shurik179/servo_controller/docs/photos/PXL_20240618_205056550.jpg

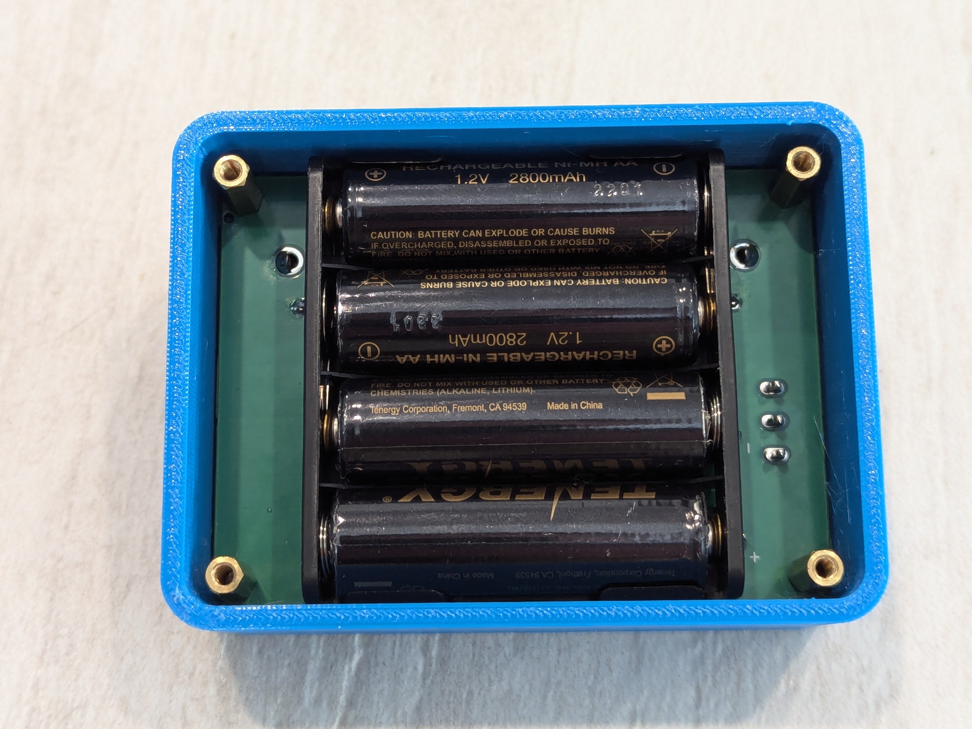
docs/photos/PXL_20240618_205056550.jpg
