shurik179/servo_controller/docs/photos/PXL_20240618_210146403.jpg

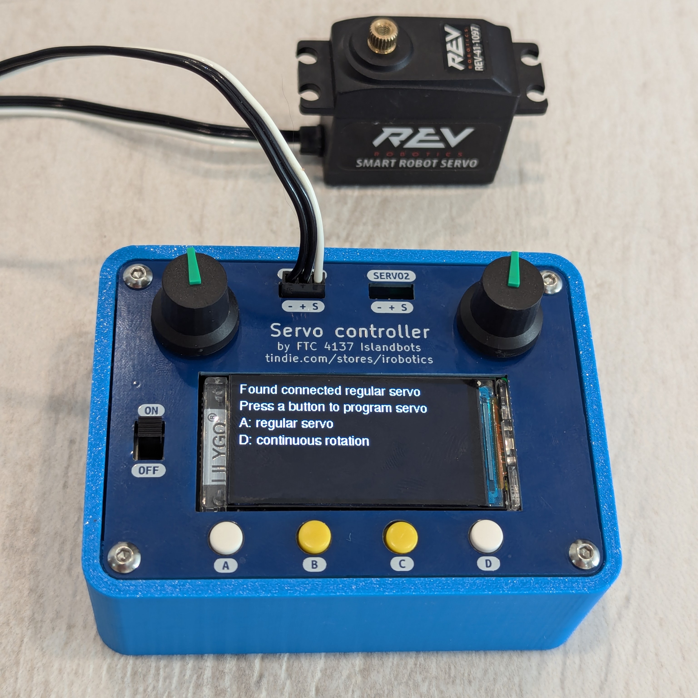
docs/photos/PXL_20240618_210146403.jpg
