shurik179/servo_controller/README.md

# Servo controller
This repository contains source files for the dual Servo Controller, desinged by members 
of FTC team 4137 Islandbots. 

For details, please see https://tindie.com/stores/irobotics/servo-controller
