shurik179/servo_controller/docs/photos/PXL_20240614_215525918.jpg

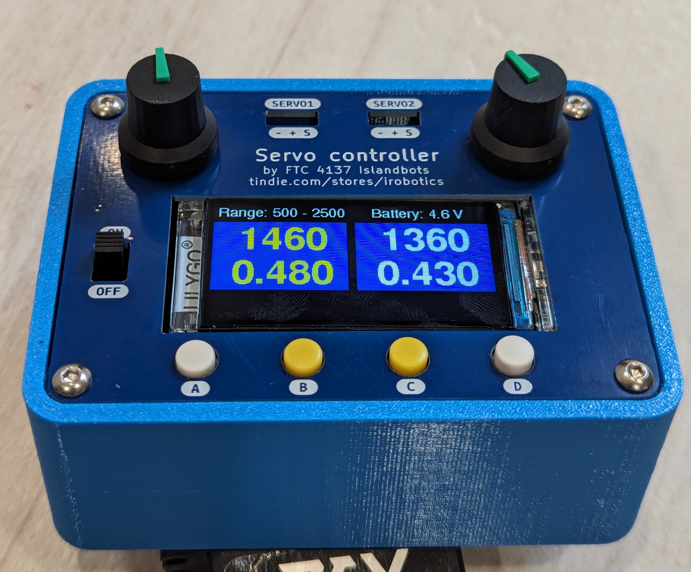
docs/photos/PXL_20240614_215525918.jpg
