shurik179/servo_controller/docs/photos/servo-controller-tindie.png

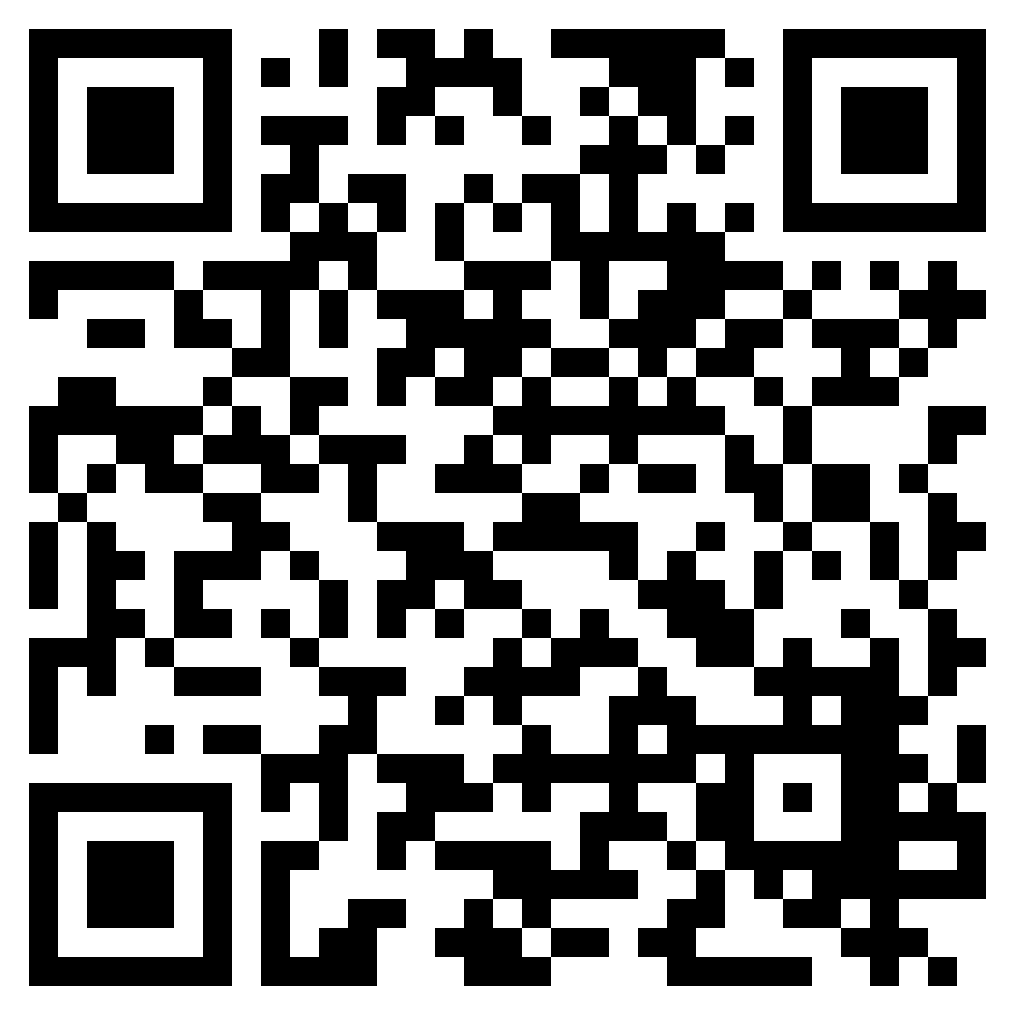
docs/photos/servo-controller-tindie.png
