shurik179/servo_controller/hardware/BOM.xlsx

Description | Vendor | URL | Quantity
3d printed
case |  |  | 1
Ordered from JLCPCB
Mainboard | JLCPCB
Top panel | JLCPCB
Bottom panel | JLCPCB
Mainboard additional components
T-Display-S3 MCU with display | LILYGO | https://www.lilygo.cc/products/t-display-s3?variant=42351558590645 | 1
Potentiometer, 10k, linear | Digikey | https://www.digikey.com/en/products/detail/bourns-inc/PTV09A-4225S-B103/3820587 | 2
Potentiometer knob | Digikey | https://www.digikey.com/en/products/detail/cliff-electronic-components-ltd/CL170847CR/15928687 | 2
Battery holder, 4AA batteries, pins | AliExpress | https://www.aliexpress.us/item/3256806236649210.html | 1 | https://www.aliexpress.us/item/3256805326967469.html | https://www.digikey.com/en/products/detail/keystone-electronics/2477/303822
Hardware
M3 buttonhead screw, 18mm | McMaster | https://www.mcmaster.com/92095A472/ | 4
M3 buttonhead screw, 5mm |  |  | 2
M3 brass standoff, 18mm | AliExpress | https://www.aliexpress.us/item/2255800053420766.html | 4
M3 flathead screw, 12 mm | McMaster | https://www.mcmaster.com/92125A132/ | 2
