shurik179/servo_controller/hardware/mainboard-v2/jlcpcb/production_files/BOM-mainboard.csv

Comment | Designator | Footprint | LCSC
SN74LVC2G241DCY | U2 | VSSOP-8_2.3x2mm_P0.5mm | C10430
220uF | C5 | CP_Elec_6.3x7.7 | C131158
0.1uF | C1,C2 | C_0603_1608Metric | C14663
D_Schottky | D1 | D_SOD-323 | C191023
10K | R1,R2,R3 | R_0603_1608Metric | C25804
SW_SPST | SW2,SW3,SW4,SW5 | SW_TH_Tactile_Omron_B3F-10xx | C2885143
SW_SPDT | SW1 | SW_XKB_SS12D10L3 | C319011
22uF | C3,C4 | C_0805_2012Metric | C45783
Conn_01x03 | J3,J4 | PinHeader_1x03_P2.54mm_Vertical | C49257
TXB0104PWR | U1 | TSSOP-14_4.4x5mm_P0.65mm | C60708
R_Potentiometer | RV2 | Potentiometer_Bourns_PTV09A-1_Single_Vertical
T-Display-S3 | U3 | T-Display-S3
R_Potentiometer | RV1 | Potentiometer_Bourns_PTV09A-1_Single_Vertical
