shurik179/servo_controller/hardware/bottomboard/bottomboard.step

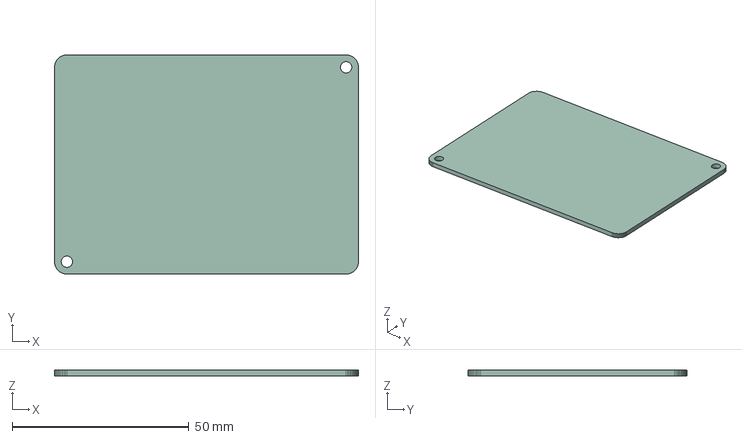
[picture p7: CAD file, 2024-06-10]
hardware/bottomboard/bottomboard.step
86.0 x 62.0 x 1.60 mm
