shurik179/servo_controller/hardware/case v12.step

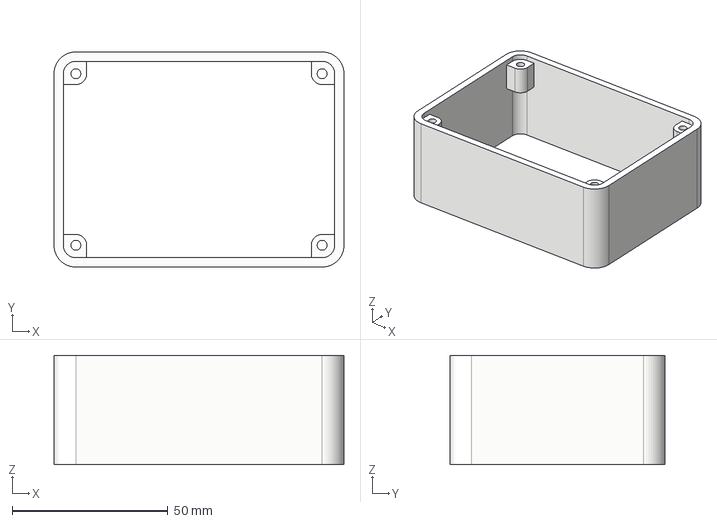
[picture p8: CAD file, 2024-06-19]
hardware/case v12.step
93.0 x 69.0 x 35.0 mm
