shurik179/servo_controller/hardware/topboard/topboard.step

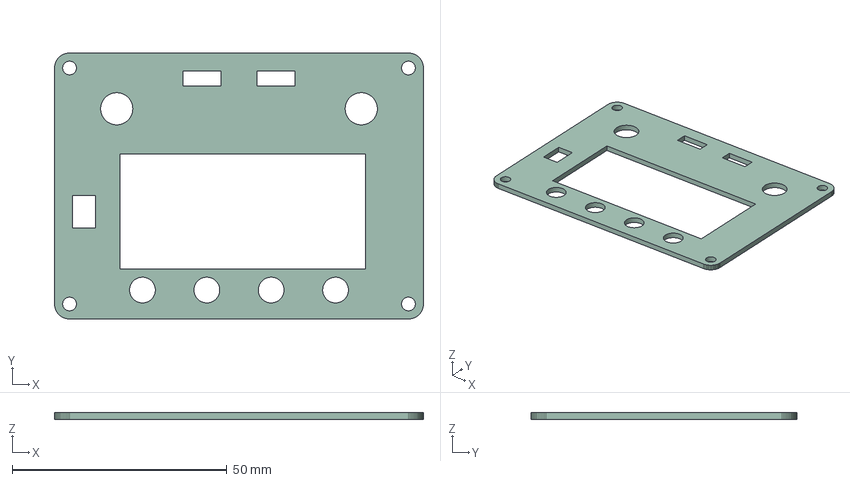
[picture p9: CAD file, 2024-06-10]
hardware/topboard/topboard.step
86.0 x 62.0 x 1.60 mm
