shurik179/servo_controller/(list of files, cad)

Other CAD files:
hardware/case.step
