shurik179/servo_controller/(commit log)

2024-05-24 adding 3d models to KiCad
    [mainboard.kicad_pcb]
2024-05-29 getting ready for beta2
    [bottom_board-CuBottom.gbr, bottom_board-CuTop.gbr, bottom_board-EdgeCuts.gbr, bottom_board-MaskBottom.gbr, bottom_board-MaskTop.gbr, bottom_board-NPTH.drl, bottom_board-PTH.drl, bottom_board-PasteBottom.gbr]
2024-05-31 more work on code
    [bottom_board.kicad_pcb, mainboard.kicad_pcb, mainboard.kicad_sch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]
2024-05-31 moving the t-display
    [mainboard.kicad_pcb, topboard.kicad_pcb]
2024-05-31 kicad files update
    [bottom_board-CuBottom.gbr, bottom_board-CuTop.gbr, bottom_board-EdgeCuts.gbr, bottom_board-MaskBottom.gbr, bottom_board-MaskTop.gbr, bottom_board-NPTH.drl, bottom_board-PTH.drl, bottom_board-PasteBottom.gbr]
2024-06-01 adding QR code
    [bottom_board-CuBottom.gbr, bottom_board-CuTop.gbr, bottom_board-EdgeCuts.gbr, bottom_board-MaskBottom.gbr, bottom_board-MaskTop.gbr, bottom_board-NPTH.drl, bottom_board-PTH.drl, bottom_board-PasteBottom.gbr]
2024-06-05 board update
    [bottom_board-CuBottom.gbr, bottom_board-CuTop.gbr, bottom_board-EdgeCuts.gbr, bottom_board-MaskBottom.gbr, bottom_board-MaskTop.gbr, bottom_board-NPTH.drl, bottom_board-PTH.drl, bottom_board-PasteBottom.gbr]
2024-06-07 version 1.0.0
    [bottom_board-CuBottom.gbr, bottom_board-CuTop.gbr, bottom_board-EdgeCuts.gbr, bottom_board-MaskBottom.gbr, bottom_board-MaskTop.gbr, bottom_board-NPTH.drl, bottom_board-PTH.drl, bottom_board-PasteBottom.gbr]
2024-06-10 updated 3d model; added BOM
    [bottom_board-CuBottom.gbr, bottom_board-CuTop.gbr, bottom_board-EdgeCuts.gbr, bottom_board-MaskBottom.gbr, bottom_board-MaskTop.gbr, bottom_board-NPTH.drl, bottom_board-PTH.drl, bottom_board-PasteBottom.gbr]
2024-06-15 minor modification to 3d printed case
    [case.step]
2024-06-19 added servo programming
    [BOM-mainboard.csv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]
2024-06-19 added photos
    [case v12.step, servo_mode_dump.txt]
2024-06-24 pcb update for v1.1
    [mainboard-v1.1.kicad_pcb]
2025-10-31 updating firmware for v 1.1
    [bom.csv, designators.csv, mainboard-v1.1.kicad_pcb, mainboard-v1.1.kicad_sch, positions.csv]
